EvilForge/D14Props/Access - Step 2.jpg

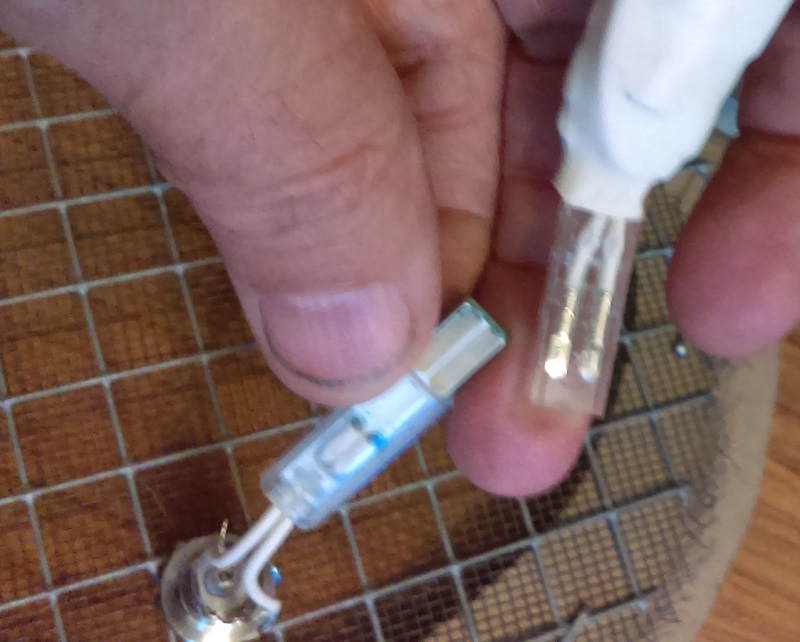
Access - Step 2.jpg
