EvilForge/D14Props/After - Installed Carrier.jpg

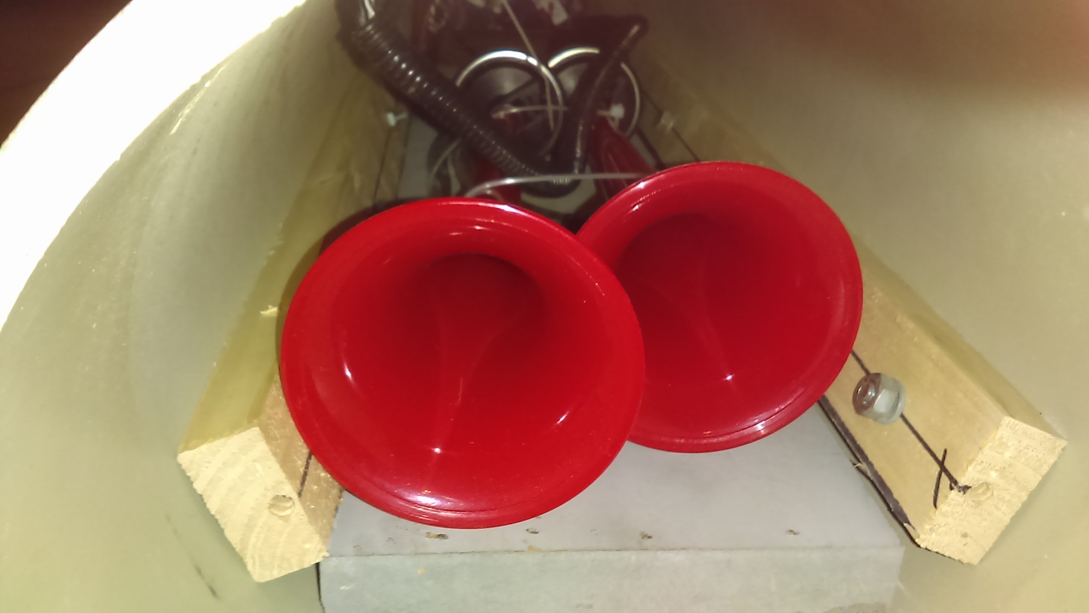
After - Installed Carrier.jpg
