EvilForge/D14Props/README.md

# D14Props
Prop info for D14, circa 2016
