EvilForge/D14Props/Access - Carried Board.jpg

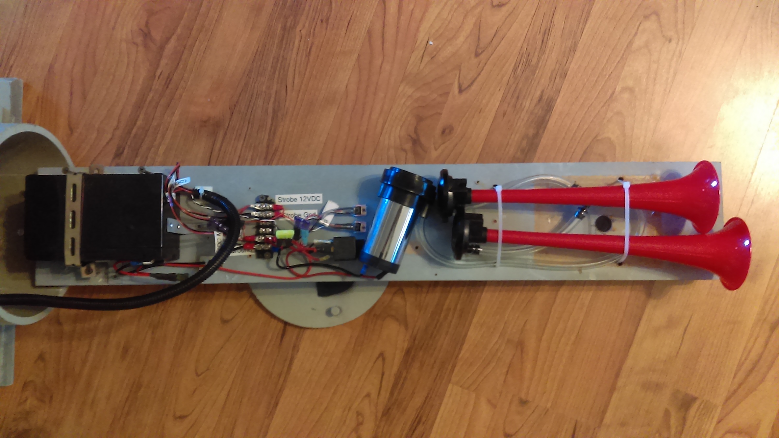
Access - Carried Board.jpg
