EvilForge/D14Props/After - Back View.jpg

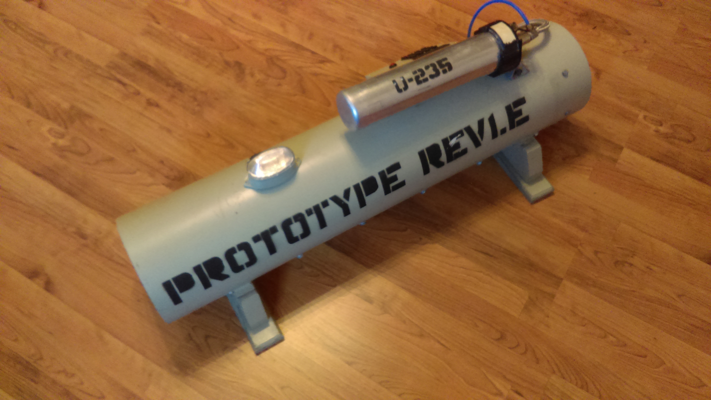
After - Back View.jpg
