EvilForge/D14Props/After - Battery.jpg

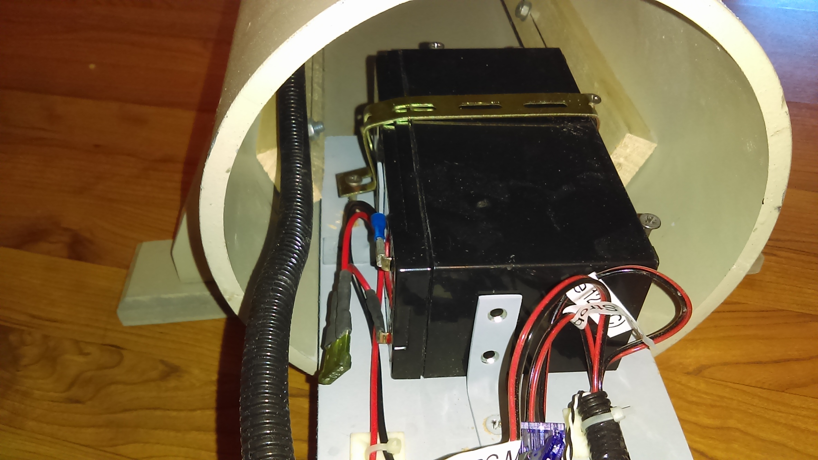
After - Battery.jpg
