EvilForge/D14Props/After - Exploded.jpg

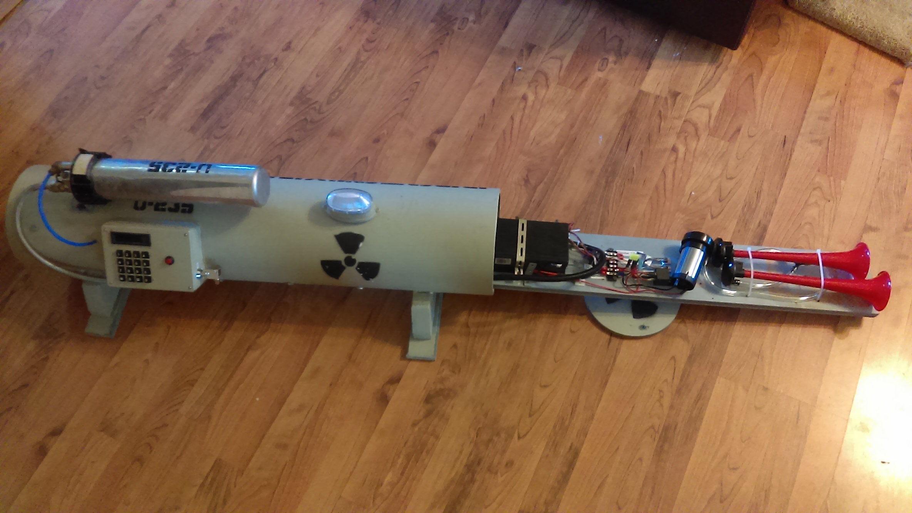
After - Exploded.jpg
