EvilForge/D14Props/After - Front View.jpg

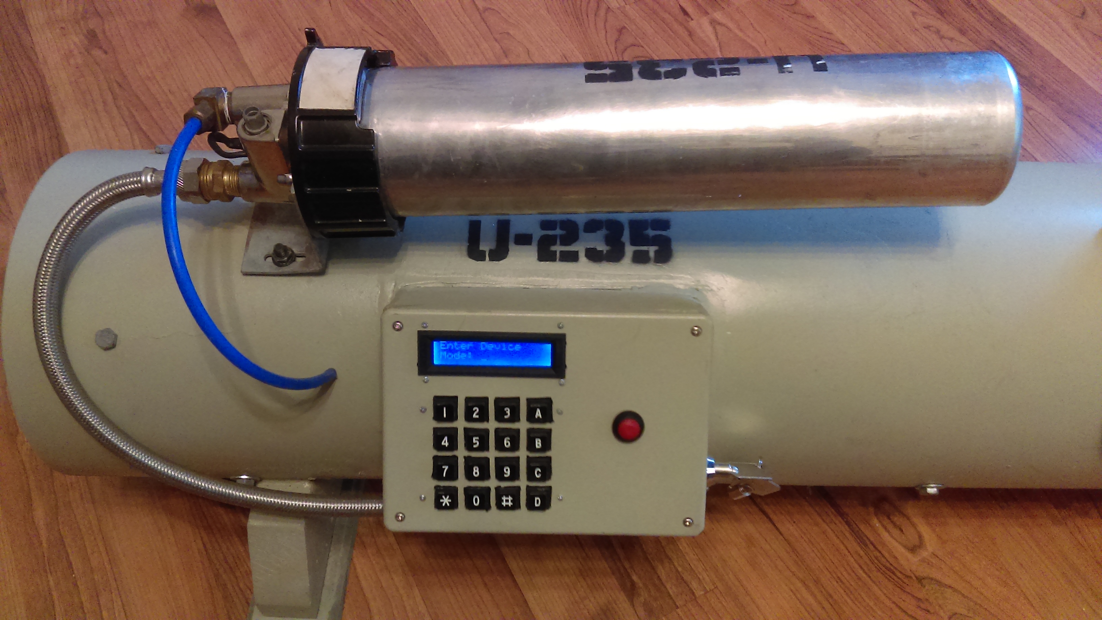
After - Front View.jpg
