EvilForge/D14Props/After - Full View.jpg

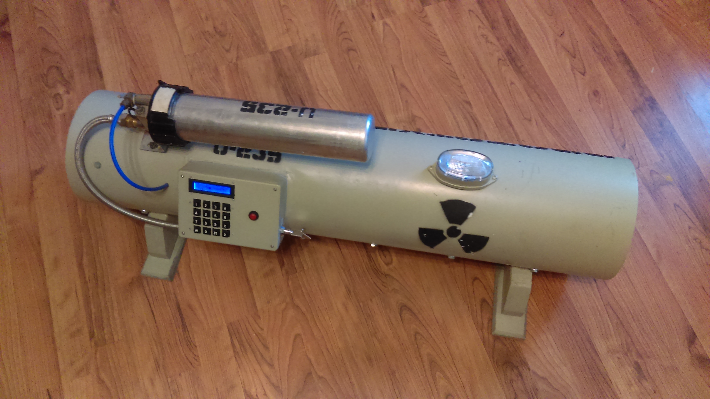
After - Full View.jpg
