EvilForge/D14Props/After - Key Switch.jpg

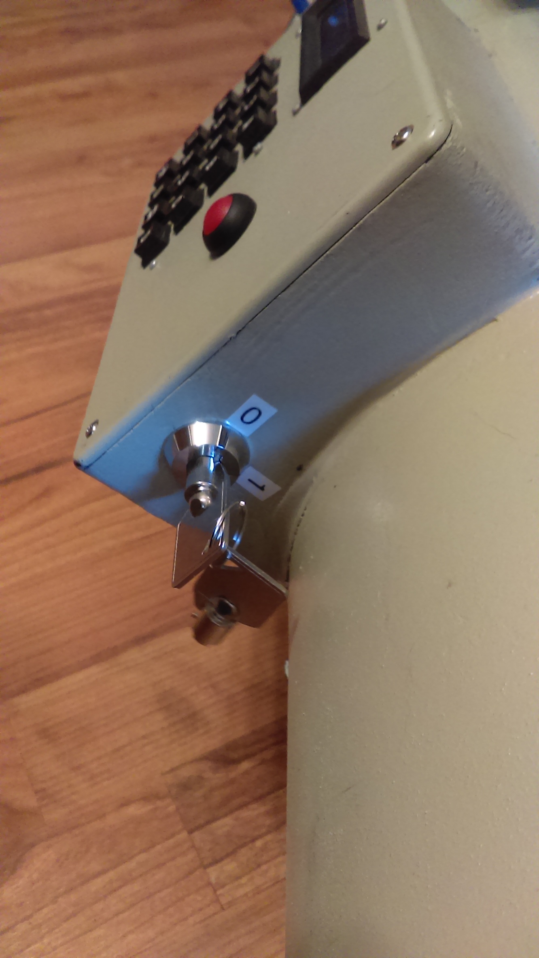
After - Key Switch.jpg
