EvilForge/D14Props/After - Mosfet Compressor Fuses.jpg

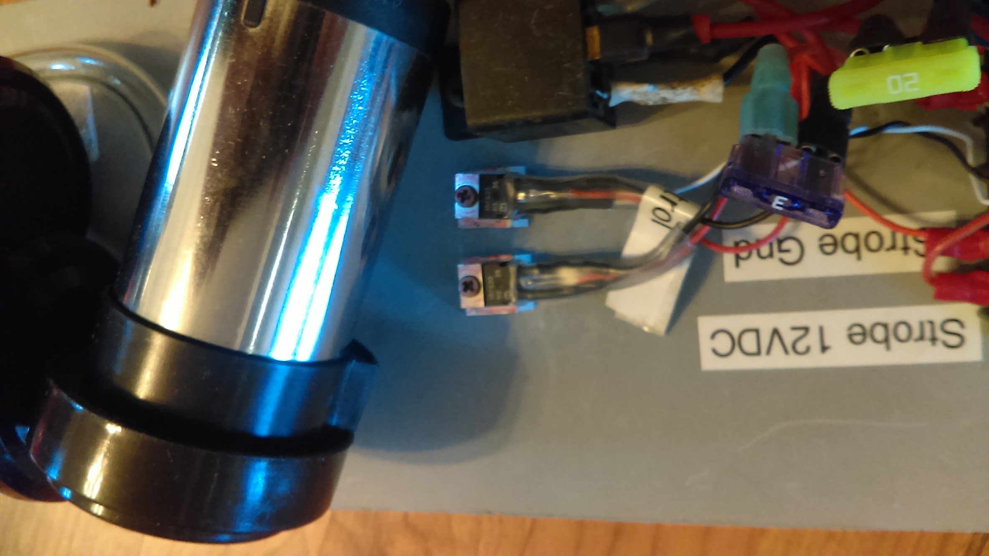
After - Mosfet Compressor Fuses.jpg
