EvilForge/D14Props/After - Top.jpg

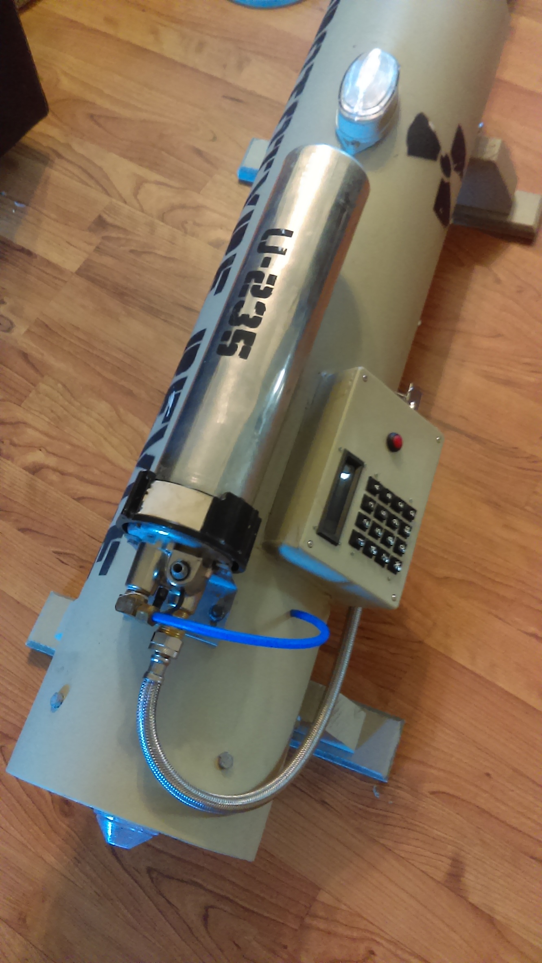
After - Top.jpg
