EvilForge/D14Props/Before - Can Switch.jpg

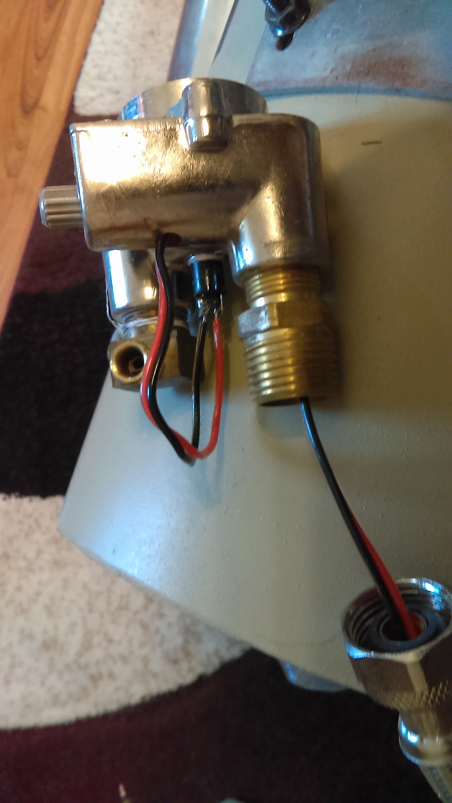
Before - Can Switch.jpg
