EvilForge/D14Props/Before - Carrier Board.jpg

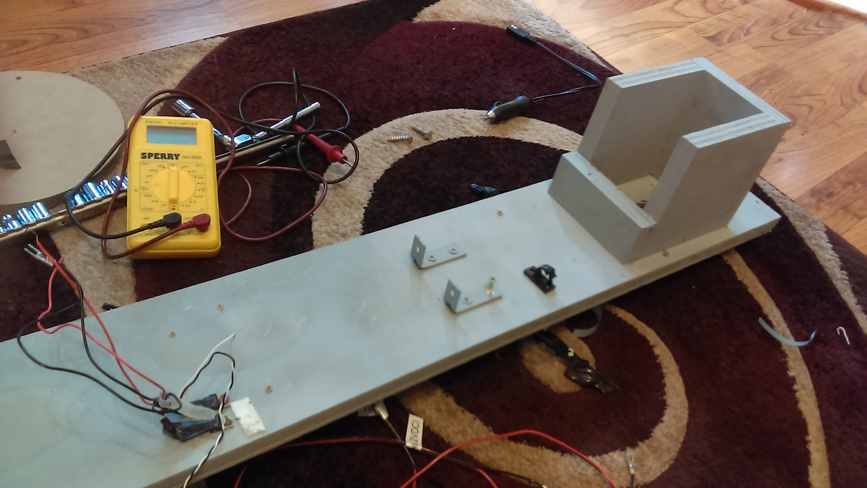
Before - Carrier Board.jpg
