EvilForge/D14Props/Before - Control Box 1.jpg

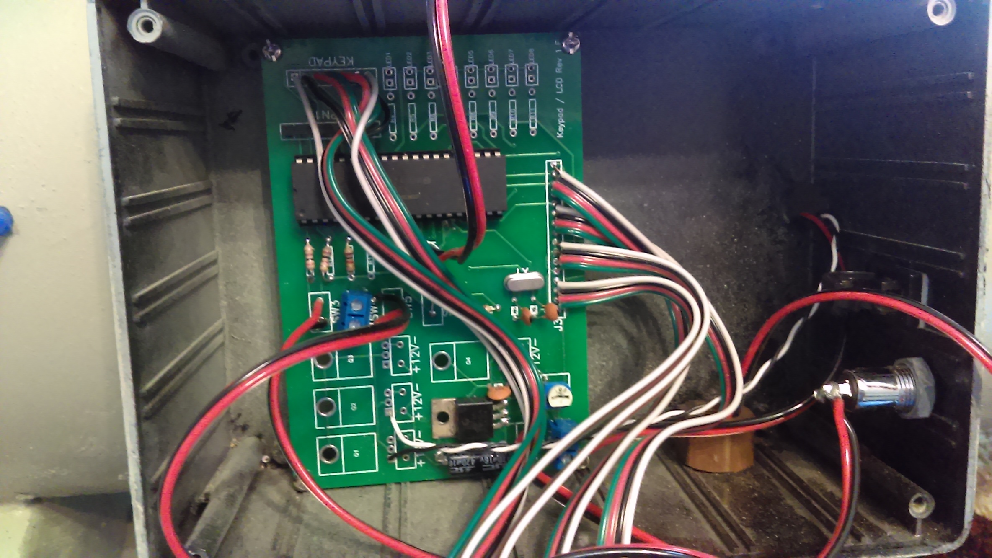
Before - Control Box 1.jpg
