EvilForge/D14Props/Before - Control Box 2.jpg

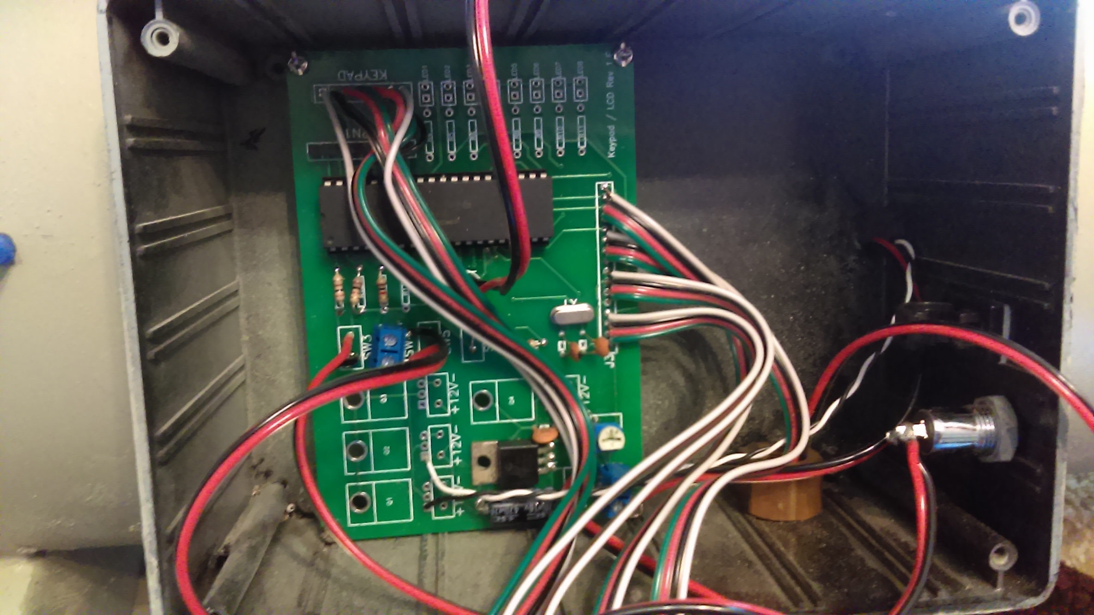
Before - Control Box 2.jpg
