EvilForge/D14Props/Before - Control Box Keypad.jpg

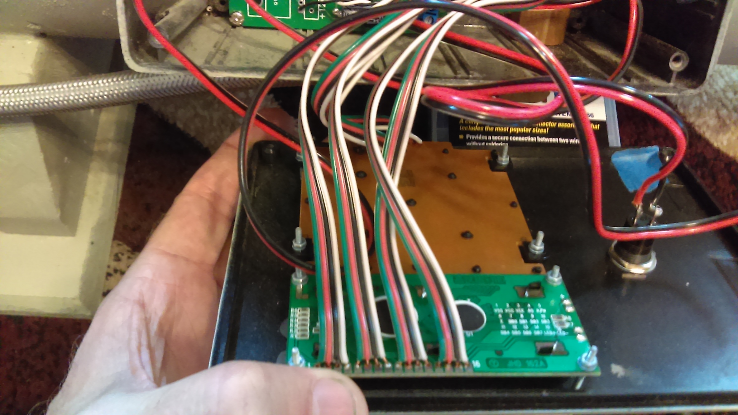
Before - Control Box Keypad.jpg
