EvilForge/D14Props/Before - Inside.jpg

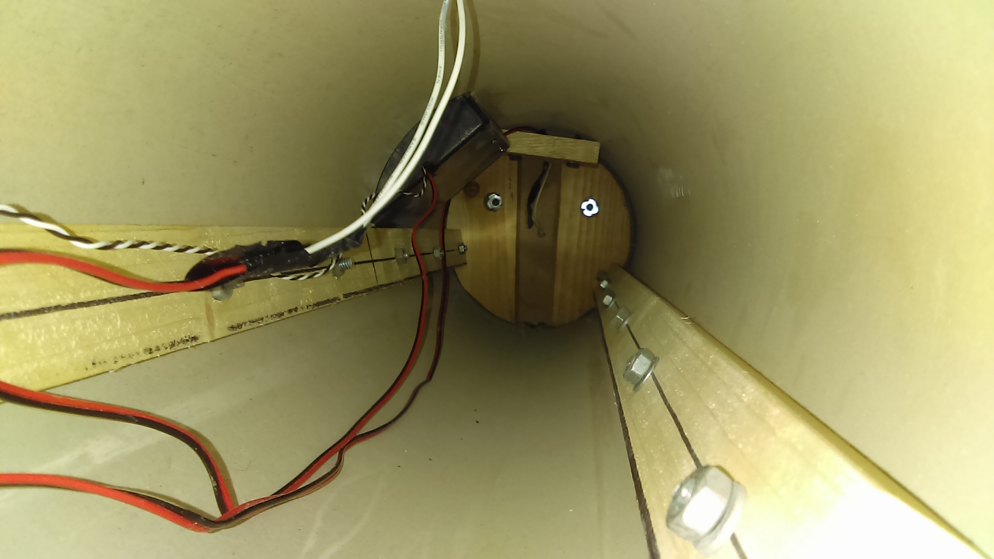
Before - Inside.jpg
