EvilForge/D14Props/Before - Mosfet.jpg

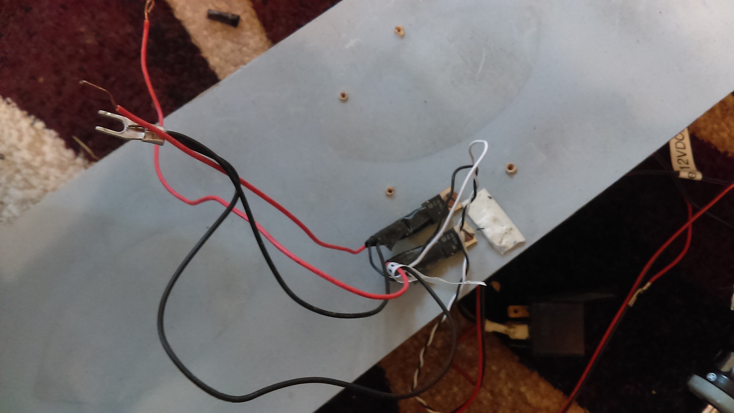
Before - Mosfet.jpg
