EvilForge/D14Props/Before - Side Strobe.jpg

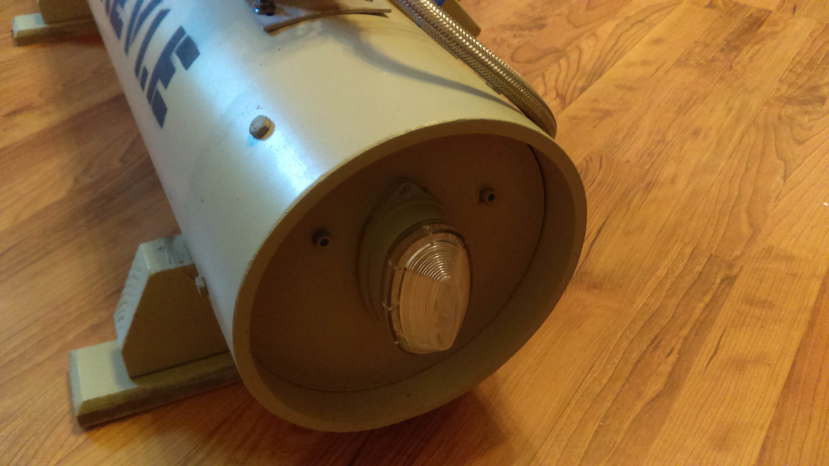
Before - Side Strobe.jpg
