EvilForge/D14Props/Before - Side View.jpg

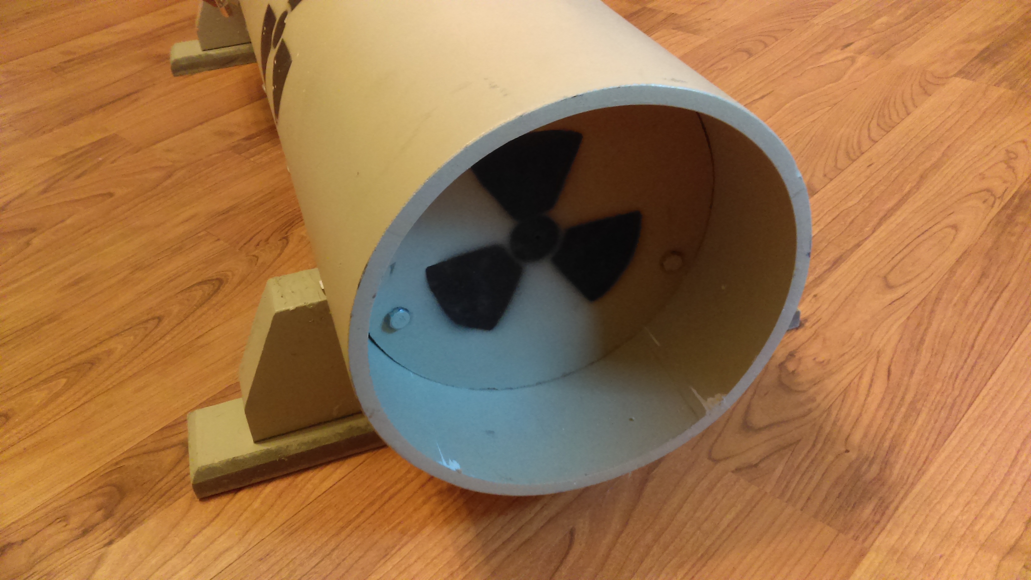
Before - Side View.jpg
