EvilForge/D14Props/Before -Initial opening.jpg

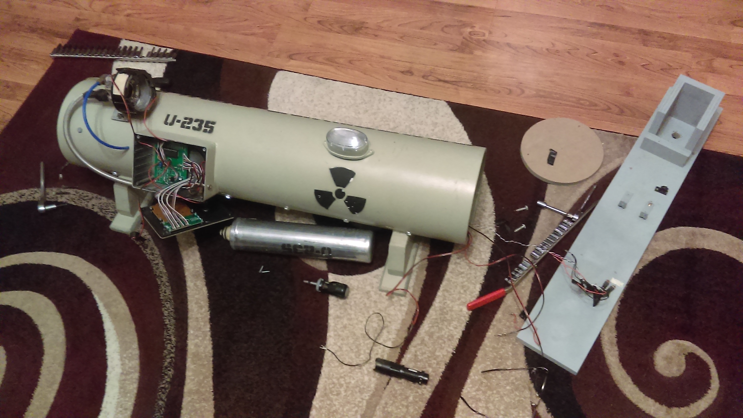
Before -Initial opening.jpg
